PrithuDas2501/Coaxial_Rotor_Thrust_Control/README.md

# Coaxial_Rotor_Thrust_Control

Please refer to the Technical Report for details on the experimental test stand using load cells and microcontrollers for real-time thrust and RPM feedback across coaxial propeller pairs.
