PrithuDas2501/Coaxial_Rotor_Thrust_Control/Daq_Controller.ino

#include <Servo.h>
#include <HX711_ADC.h>
#if defined(ESP8266)|| defined(ESP32) || defined(AVR)
#include <EEPROM.h>
#endif

//pins:
const int HX711_dout = 4; //mcu > HX711 dout pin
const int HX711_sck = 5; //mcu > HX711 sck pin

//HX711 constructor:
HX711_ADC LoadCell(HX711_dout, HX711_sck);

const int calVal_eepromAdress = 0;
unsigned long t = 0;


byte servoPin = 9;
Servo servo;
void setup(){
  Serial.begin(9600); delay(10);
  Serial.println();
  Serial.println("Starting...");

  LoadCell.begin();
  //LoadCell.setReverseOutput(); //uncomment to turn a negative output value to positive
  float calibrationValue; // calibration value (see example file "Calibration.ino")
  calibrationValue = 696.0; // uncomment this if you want to set the calibration value in the sketch
#if defined(ESP8266)|| defined(ESP32)
  //EEPROM.begin(512); // uncomment this if you use ESP8266/ESP32 and want to fetch the calibration value from eeprom
#endif
  //EEPROM.get(calVal_eepromAdress, calibrationValue); // uncomment this if you want to fetch the calibration value from eeprom

  unsigned long stabilizingtime = 2000; // preciscion right after power-up can be improved by adding a few seconds of stabilizing time
  boolean _tare = true; //set this to false if you don't want tare to be performed in the next step
  LoadCell.start(stabilizingtime, _tare);
  if (LoadCell.getTareTimeoutFlag()) {
    Serial.println("Timeout, check MCU>HX711 wiring and pin designations");
    while (1);
  }
  else {
    LoadCell.setCalFactor(calibrationValue); // set calibration value (float)
    Serial.println("Startup is complete");
  }
  
 servo.attach(servoPin);
// ESC calibration
 servo.writeMicroseconds(1000); // send "stop" signal to ESC.
 delay(4000); // delay to allow the ESC to recognize the stopped signal
  
}

void loop(){
  static boolean newDataReady = 0;
  const int serialPrintInterval = 10; //increase value to slow down serial print activity

  // check for new data/start next conversion:
  if (LoadCell.update()) newDataReady = true;

  // get smoothed value from the dataset:
  if (newDataReady) {
    if (millis() > t + serialPrintInterval) {
      float i = LoadCell.getData();
      Serial.print("Load_cell output val: ");
      Serial.println(i);
      newDataReady = 0;
      t = millis();
    }
  }

  // receive command from serial terminal, send 't' to initiate tare operation:
  //if (Serial.available() > 0) {
    //char inByte = Serial.read();
    //if (inByte == 't') LoadCell.tareNoDelay();
  //}

  // check if last tare operation is complete:
  if (LoadCell.getTareStatus() == true) {
    Serial.println("Tare complete");
  }
  
  Serial.println("Enter PWM signal value 1000 to 2000");
  
  // while (Serial.available() == 0);
  
  int val = Serial.parseInt(); 
  Serial.print(val);
  if(val < 1000 || val > 2000)
  {
    Serial.println("not valid");
  }
  else
  {
    servo.writeMicroseconds(val); // Send signal to ESC.
  }
}
